OpenFairWind/S3-Outlook-Guardian/hardware/outlook_guardian/fab/outlook_guardian-bottom.png

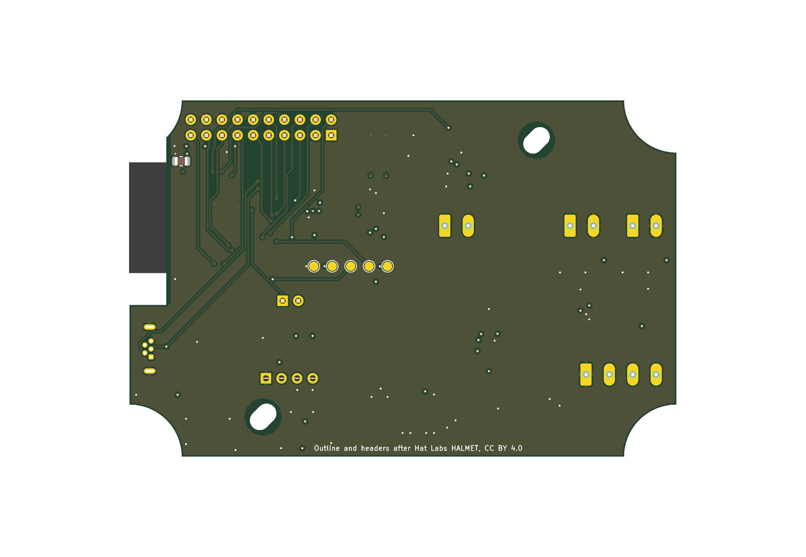
hardware/outlook_guardian/fab/outlook_guardian-bottom.png
