OpenFairWind/S3-Outlook-Guardian/hardware/outlook_guardian/fab/outlook_guardian-top.png

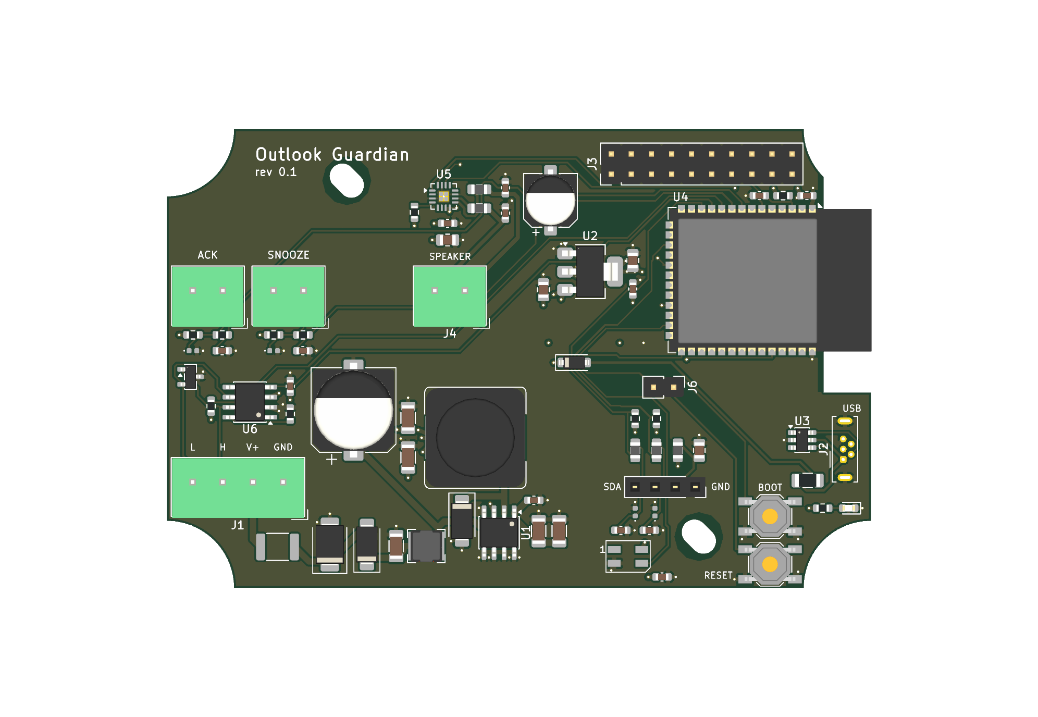
hardware/outlook_guardian/fab/outlook_guardian-top.png
