OpenFairWind/S3-Outlook-Guardian/hardware/outlook_guardian/fab/outlook_guardian-bom.csv

Reference | Value | Footprint | MPN | Qty
C1,C2,C3 | 10uF/50V | Capacitor_SMD:C_1206_3216Metric |  | 3
C4 | 100nF/50V | Capacitor_SMD:C_0603_1608Metric |  | 1
C5 | 220uF/50V | Capacitor_SMD:CP_Elec_10x10.5 |  | 1
C6,C7 | 47uF/10V | Capacitor_SMD:C_1206_3216Metric |  | 2
C8 | 220uF/10V | Capacitor_SMD:CP_Elec_6.3x7.7 |  | 1
C9,C16,C21 | 10uF/16V | Capacitor_SMD:C_0805_2012Metric |  | 3
C10,C12 | 22uF/10V | Capacitor_SMD:C_0805_2012Metric |  | 2
C11,C13,C15,C17,C20,C24,C25 | 100nF | Capacitor_SMD:C_0603_1608Metric |  | 7
C14 | 1uF | Capacitor_SMD:C_0603_1608Metric |  | 1
C18,C19 | 220pF | Capacitor_SMD:C_0603_1608Metric |  | 2
C22,C23 | 33pF | Capacitor_SMD:C_0603_1608Metric |  | 2
D1 | SMBJ33CA | Diode_SMD:D_SMB | SMBJ33CA | 1
D2,D3 | SS34 | Diode_SMD:D_SMA | SS34 | 2
D4 | B5819W | Diode_SMD:D_SOD-123 | B5819W | 1
D5 | SM24CANB | Package_TO_SOT_SMD:SOT-23 | SM24CANB-02HTG | 1
D6 | SK6812MINI | LED_SMD:LED_SK6812MINI_PLCC4_3.5x3.5mm_P1.75mm | SK6812MINI | 1
D7 | Green | LED_SMD:LED_0603_1608Metric |  | 1
D8,D9,D10,D11 | ESD5451N | Diode_SMD:D_0402_1005Metric | ESD5451N | 4
F1 | 1.1A/33V PTC | Fuse:Fuse_1812_4532Metric | 1812L110/33MR | 1
F2 | 1A/6V PTC | Fuse:Fuse_1206_3216Metric | BSMD1206-100-6V | 1
FB1,FB2 | 220R/2A | Inductor_SMD:L_0805_2012Metric | BLM21PG221SN1D | 2
FB3 | 600R | Inductor_SMD:L_0805_2012Metric | GZ2012D601TF | 1
FB4,FB5 | 100R | Inductor_SMD:L_0805_2012Metric | GZ2012D101TF | 2
J1 | NMEA 2000 / power | Connector_Phoenix_MC:PhoenixContact_MCV_1,5_4-G-3.81_1x04_P3.81mm_Vertical | Phoenix MCV 1,5/4-G-3,81 | 1
J2 | USB Micro-B | Connector_USB:USB_Micro-B_Wuerth_614105150721_Vertical | Wuerth 614105150721 | 1
J3 | GPIO | Connector_PinHeader_2.54mm:PinHeader_2x10_P2.54mm_Vertical |  | 1
J4 | Speaker | Connector_Phoenix_MC:PhoenixContact_MCV_1,5_2-G-3.81_1x02_P3.81mm_Vertical | Phoenix MCV 1,5/2-G-3,81 | 1
J5 | Display | Connector_PinSocket_2.54mm:PinSocket_1x04_P2.54mm_Vertical |  | 1
J6 | EN / IO0 | Connector_PinHeader_2.54mm:PinHeader_1x02_P2.54mm_Vertical |  | 1
J7 | Acknowledge | Connector_Phoenix_MC:PhoenixContact_MCV_1,5_2-G-3.81_1x02_P3.81mm_Vertical | Phoenix MCV 1,5/2-G-3,81 | 1
J8 | Snooze | Connector_Phoenix_MC:PhoenixContact_MCV_1,5_2-G-3.81_1x02_P3.81mm_Vertical | Phoenix MCV 1,5/2-G-3,81 | 1
L1 | 10uH/1.5A | Inductor_SMD:L_Bourns-SRN4018 | SRN4018-100M | 1
L2 | 47uH/3A | Inductor_SMD:L_Bourns_SRR1260 | SRR1260-470M | 1
R1 | 2k | Resistor_SMD:R_0603_1608Metric |  | 1
R2,R4,R5,R8,R10 | 10k | Resistor_SMD:R_0603_1608Metric |  | 5
R3 | 1M | Resistor_SMD:R_0603_1608Metric |  | 1
R6,R7 | 4.7k | Resistor_SMD:R_0603_1608Metric |  | 2
R9,R11 | 1k | Resistor_SMD:R_0603_1608Metric |  | 2
SW1 | BOOT | Button_Switch_SMD:SW_SPST_TL3342 | TL3342F160QG | 1
SW2 | RESET | Button_Switch_SMD:SW_SPST_TL3342 | TL3342F160QG | 1
U1 | XL1509-5.0E1 | Package_SO:SOIC-8_3.9x4.9mm_P1.27mm | XL1509-5.0E1 | 1
U2 | AZ1117C-3.3 | Package_TO_SOT_SMD:SOT-223-3_TabPin2 | AZ1117CH-3.3TRG1 | 1
U3 | USBLC6-2SC6 | Package_TO_SOT_SMD:SOT-23-6 | USBLC6-2SC6 | 1
U4 | ESP32-S3-WROOM-1-N16R8 | OutlookGuardian:ESP32-S3-WROOM-1_EdgeAntenna | ESP32-S3-WROOM-1-N16R8 | 1
U5 | MAX98357AETE+T | Package_DFN_QFN:TQFN-16-1EP_3x3mm_P0.5mm_EP1.23x1.23mm | MAX98357AETE+T | 1
U6 | SN65HVD230DR | Package_SO:SOIC-8_3.9x4.9mm_P1.27mm | SN65HVD230DR | 1
