OpenFairWind/S3-Outlook-Guardian/hardware/outlook_guardian/fab/outlook_guardian-schematic.pdf

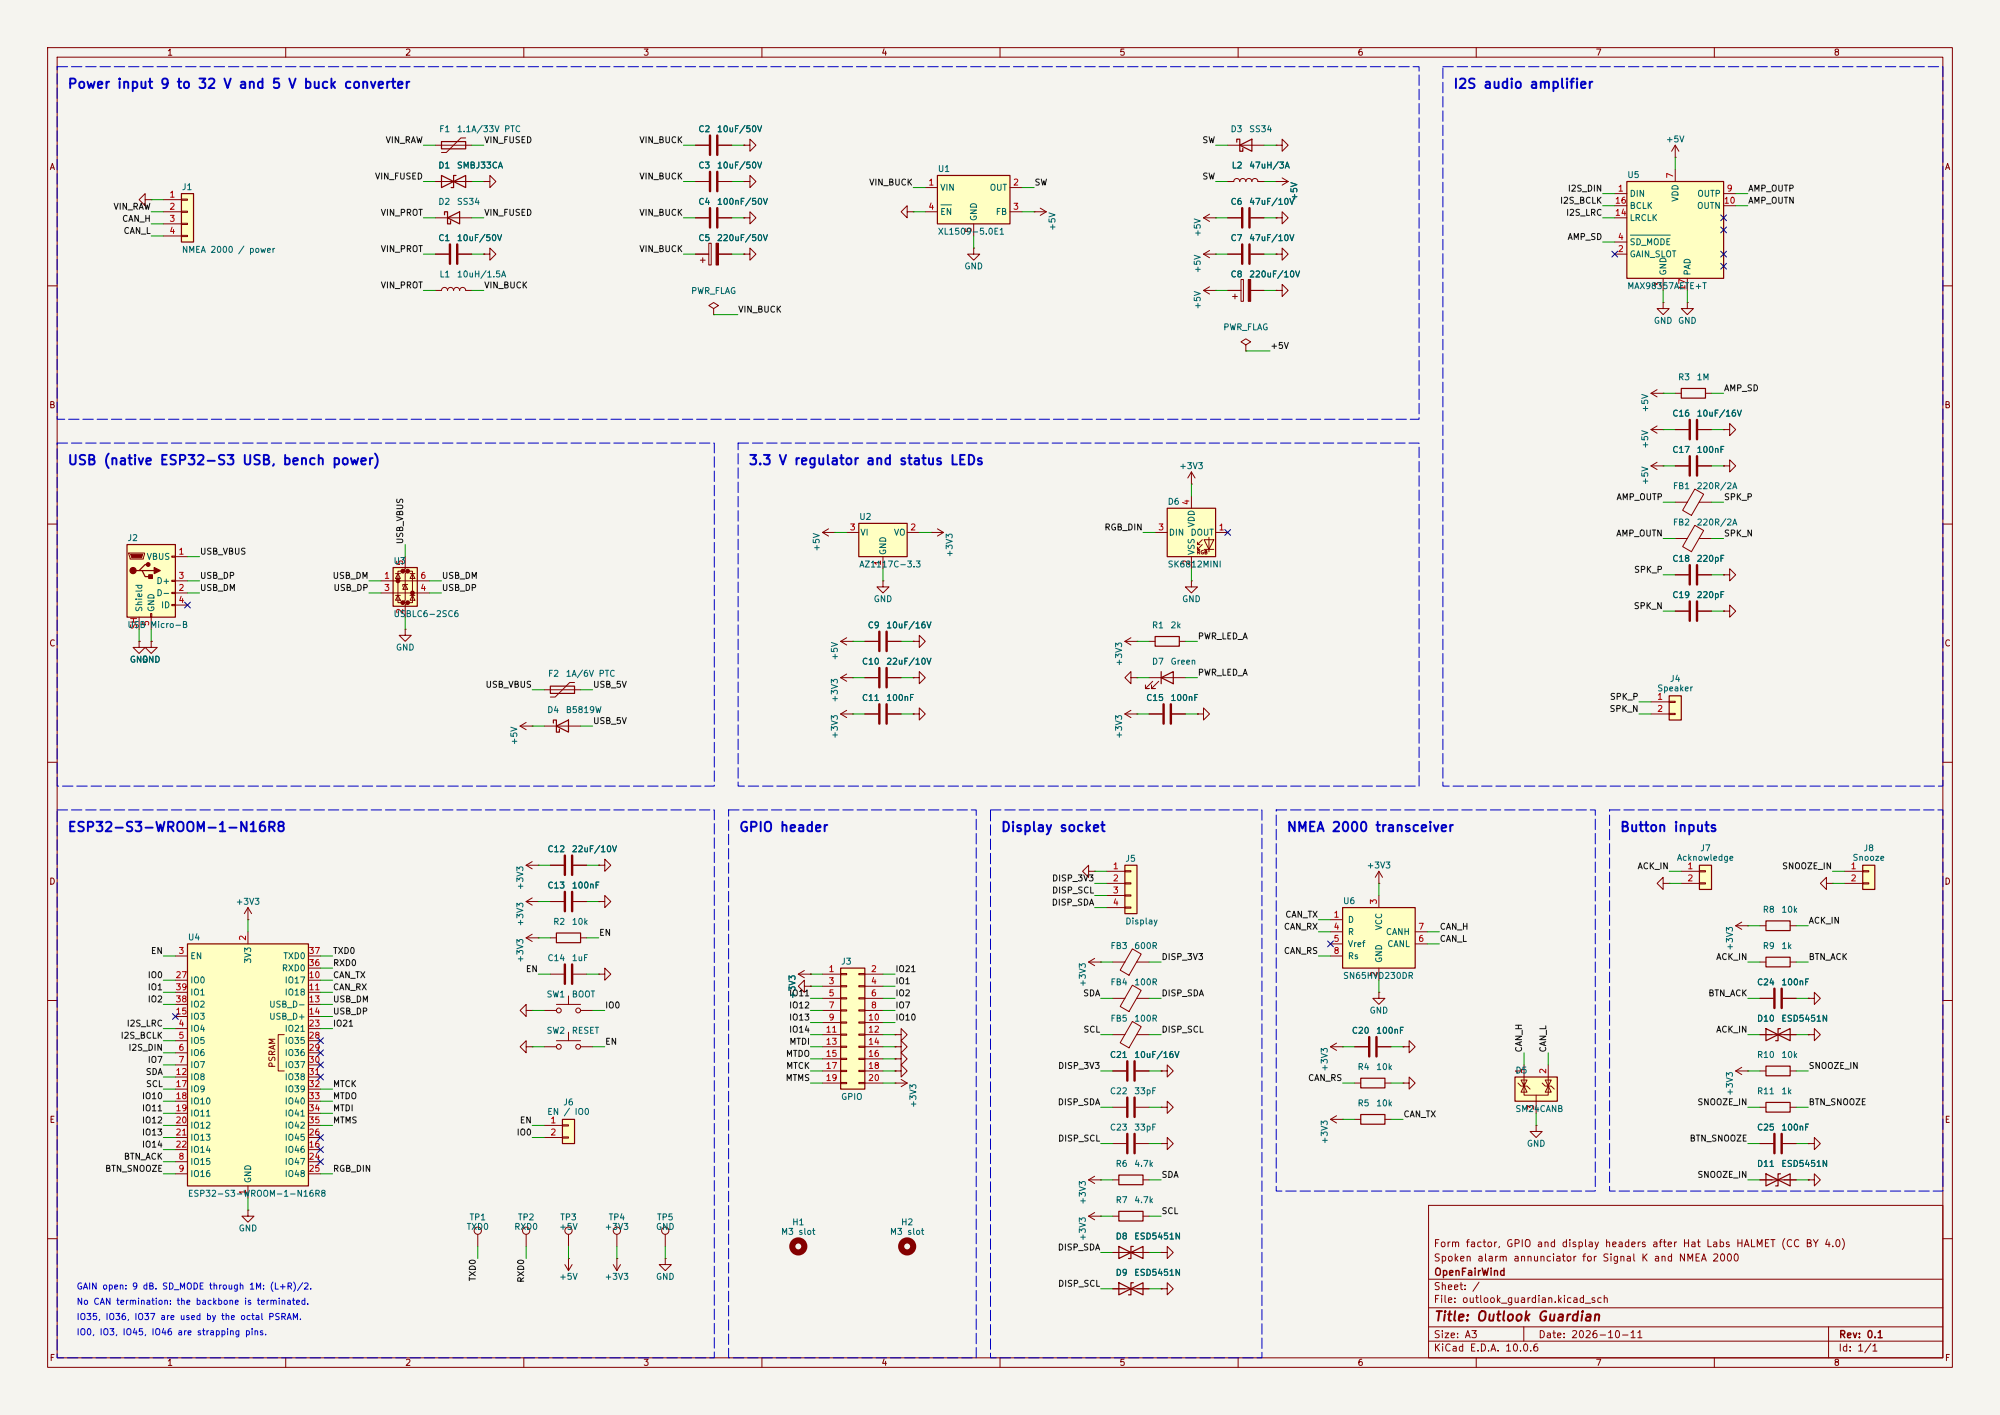
[picture p4: page 1]

Power input 9 to 32 V and 5 V buck converter

No CAN termination: the backbone is terminated. ESP32-S3-WROOM-1-N16R8

Spoken alarm annunciator for Signal K and NMEA 2000
OpenFairWind
Sheet: /
File: outlook_guardian.kicad_sch
Title: Outlook Guardian

IO35, IO36, IO37 are used by the octal PSRAM. GAIN open: 9 dB. SD_MODE through 1M: (L+R)/2.

Size: A3 | Rev: 0.1 | F Date: 2026-10-11
KiCad E.D.A. 10.0.6 | Id: 1/1
