OpenFairWind/S3-Outlook-Guardian/hardware/outlook_guardian/fab/outlook_guardian-assembly.pdf

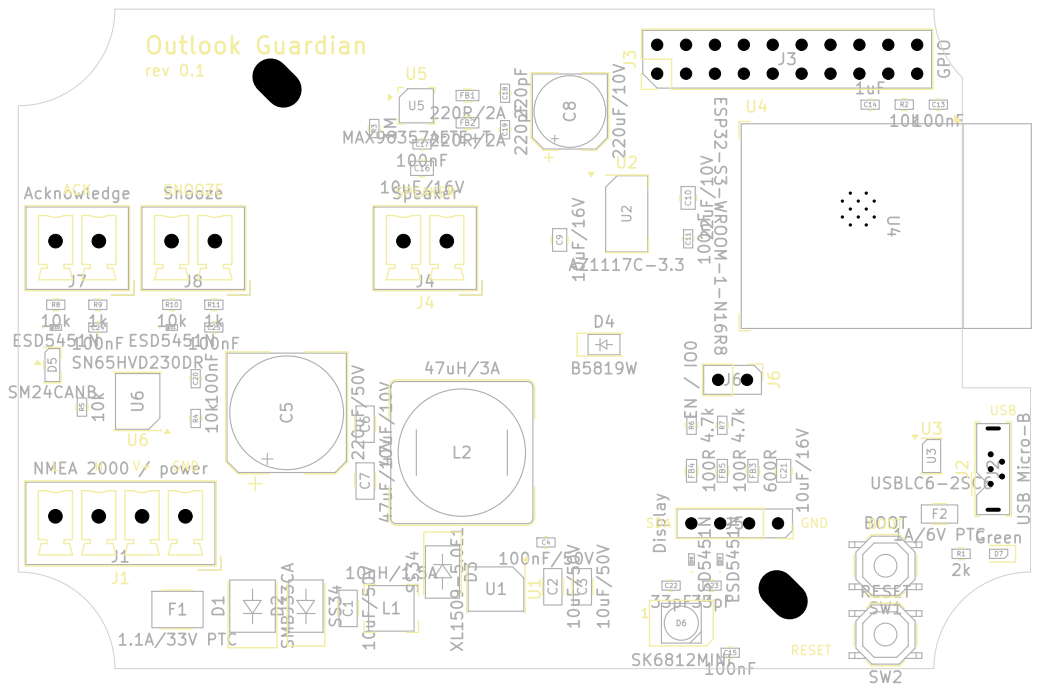
[picture p5: page 1]
