OpenFairWind/S3-Outlook-Guardian/hardware/outlook_guardian/outlook_guardian.kicad_pcb

## KiCad design hardware/outlook_guardian/outlook_guardian.kicad_pcb (2026-10-11)

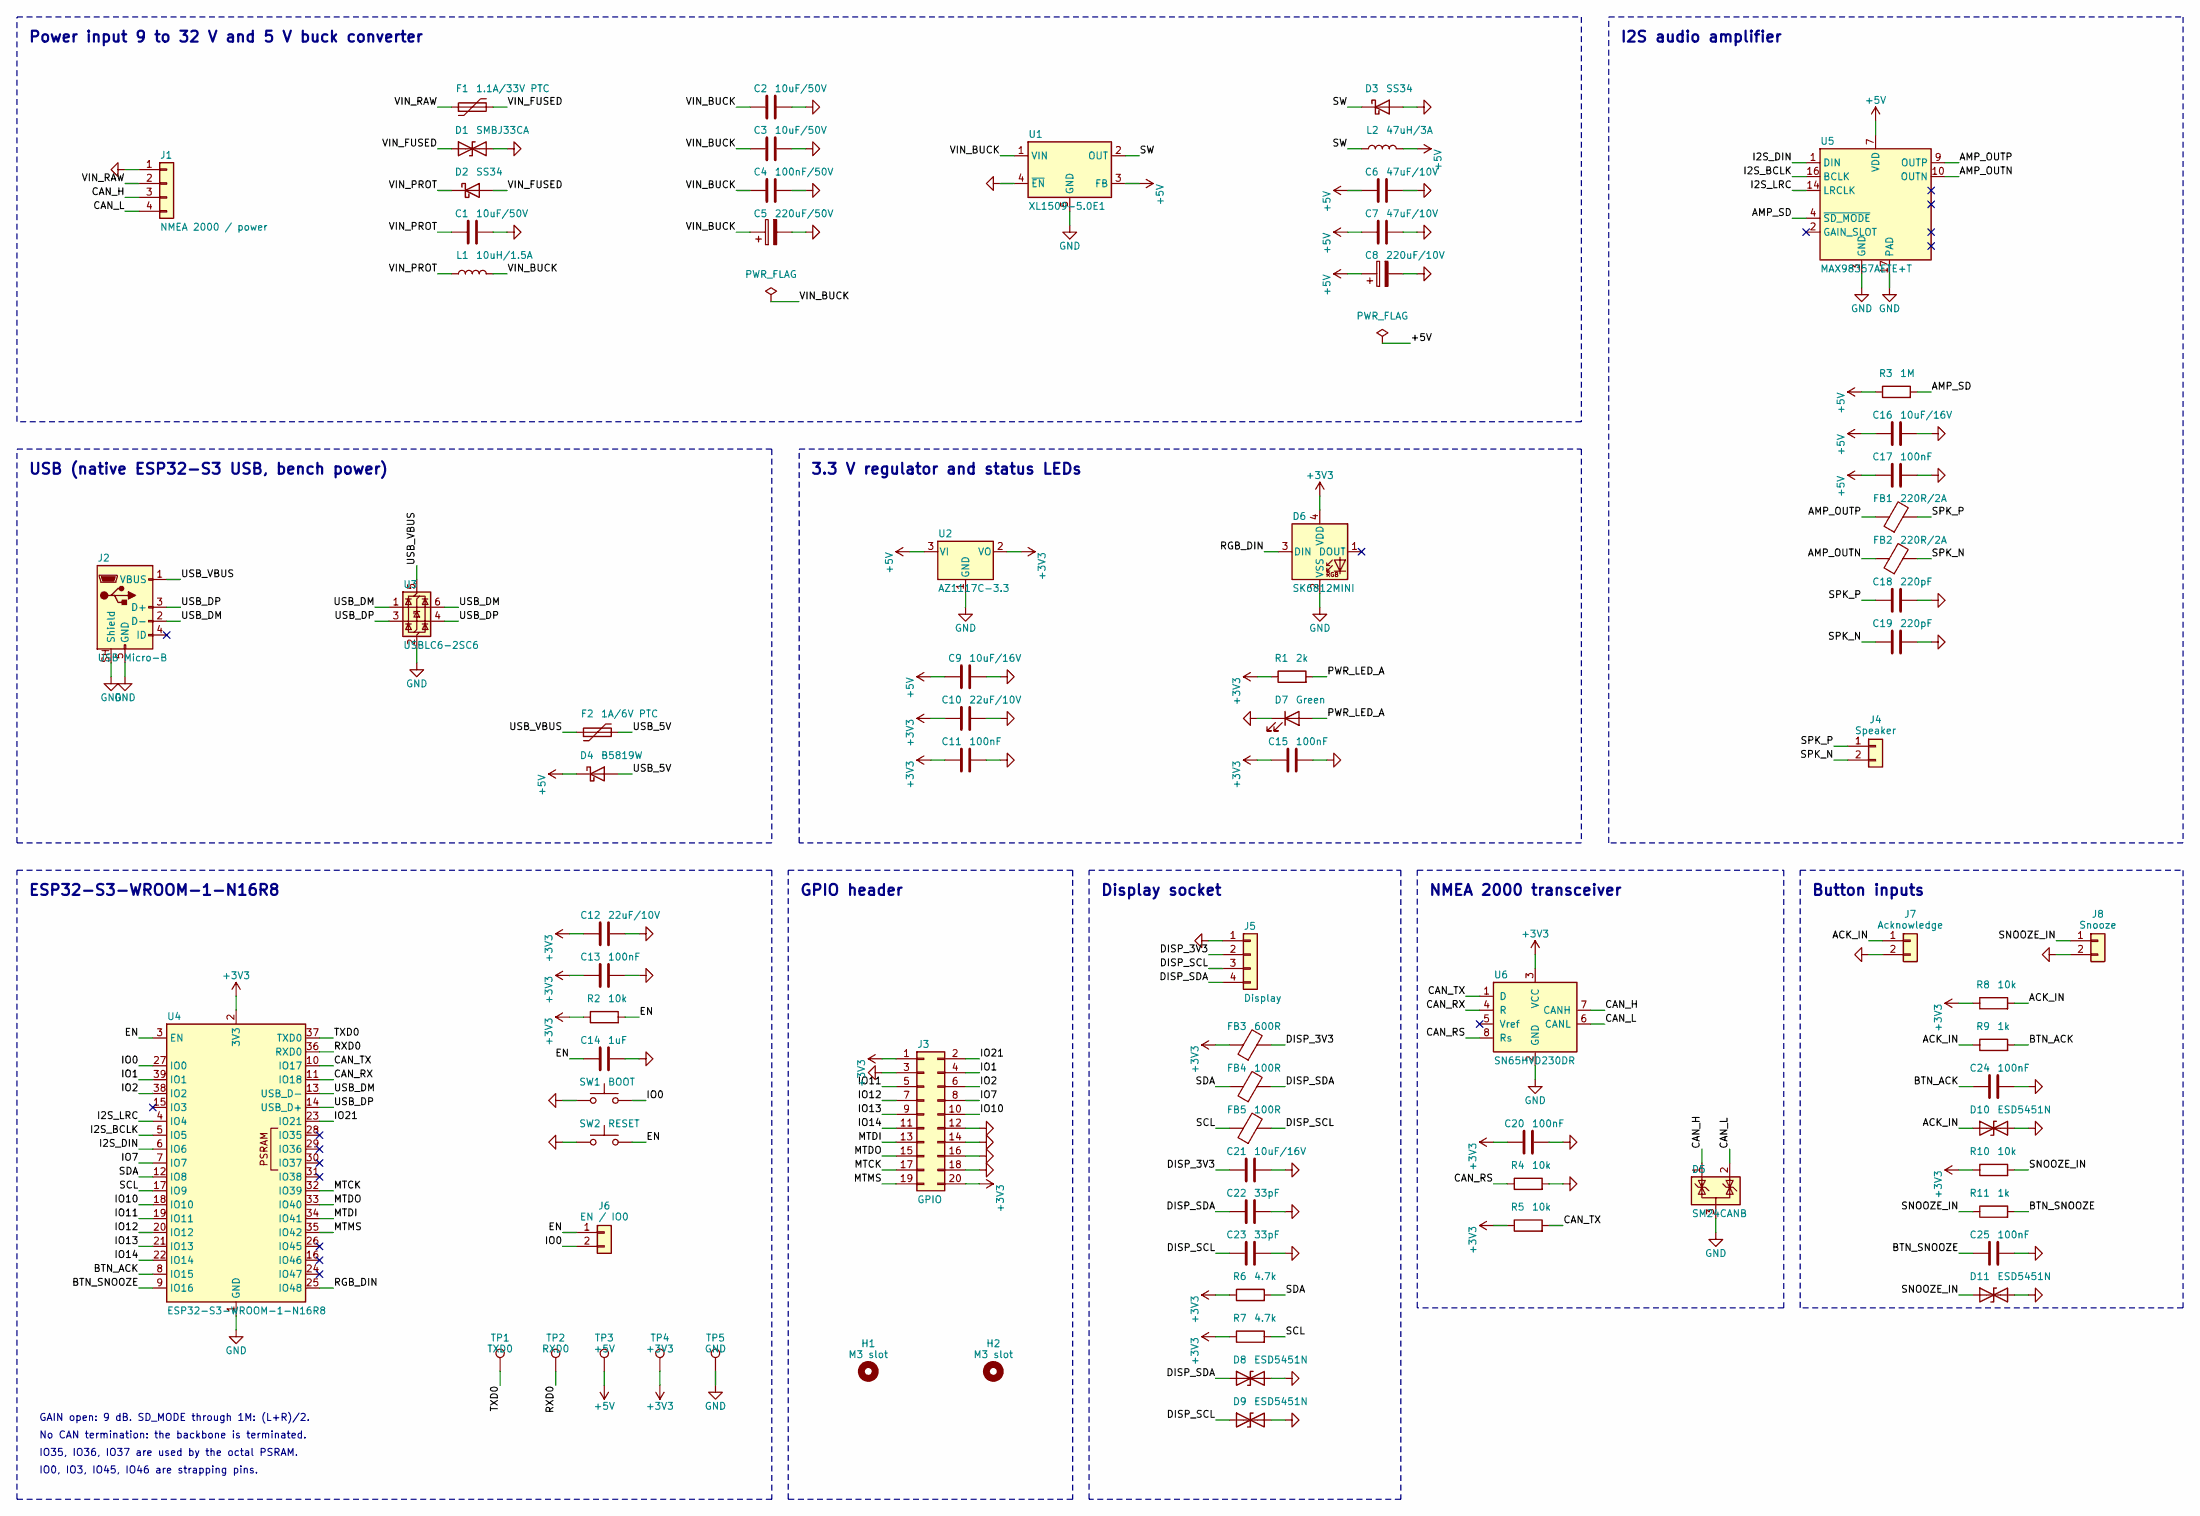
[picture p6: schematic outlook_guardian.kicad_sch, Outlook Guardian]

Parts:
C1, C2, C3: 10uF/50V; C_1206_3216Metric
C4: 100nF/50V; C_0603_1608Metric
C5: 220uF/50V; CP_Elec_10x10.5
C6, C7: 47uF/10V; C_1206_3216Metric
C8: 220uF/10V; CP_Elec_6.3x7.7
C9, C16, C21: 10uF/16V; C_0805_2012Metric
C10, C12: 22uF/10V; C_0805_2012Metric
C11, C13, C15, C17, C20, C24, C25: 100nF; C_0603_1608Metric
C14: 1uF; C_0603_1608Metric
C18, C19: 220pF; C_0603_1608Metric
C22, C23: 33pF; C_0603_1608Metric
D1: SMBJ33CA; D_SMB; MPN SMBJ33CA
D2, D3: SS34; D_SMA; MPN SS34
D4: B5819W; D_SOD-123; MPN B5819W
D5: SM24CANB; SOT-23; MPN SM24CANB-02HTG
D6: SK6812MINI; LED_SK6812MINI_PLCC4_3.5x3.5mm_P1.75mm; MPN SK6812MINI
D7: Green; LED_0603_1608Metric
D8, D9, D10, D11: ESD5451N; D_0402_1005Metric; MPN ESD5451N
F1: 1.1A/33V PTC; Fuse_1812_4532Metric; MPN 1812L110/33MR
F2: 1A/6V PTC; Fuse_1206_3216Metric; MPN BSMD1206-100-6V
FB1, FB2: 220R/2A; L_0805_2012Metric; MPN BLM21PG221SN1D
FB3: 600R; L_0805_2012Metric; MPN GZ2012D601TF
FB4, FB5: 100R; L_0805_2012Metric; MPN GZ2012D101TF
H1, H2: M3 slot; MountingSlot_3.2mm_M3_Unplated
J1: NMEA 2000 / power; PhoenixContact_MCV_1,5_4-G-3.81_1x04_P3.81mm_Vertical; MPN Phoenix MCV 1,5/4-G-3,81
J2: USB Micro-B; USB_Micro-B_Wuerth_614105150721_Vertical; MPN Wuerth 614105150721
J3: GPIO; PinHeader_2x10_P2.54mm_Vertical
J4: Speaker; PhoenixContact_MCV_1,5_2-G-3.81_1x02_P3.81mm_Vertical; MPN Phoenix MCV 1,5/2-G-3,81
J5: Display; PinSocket_1x04_P2.54mm_Vertical
J6: EN / IO0; PinHeader_1x02_P2.54mm_Vertical
J7: Acknowledge; PhoenixContact_MCV_1,5_2-G-3.81_1x02_P3.81mm_Vertical; MPN Phoenix MCV 1,5/2-G-3,81
J8: Snooze; PhoenixContact_MCV_1,5_2-G-3.81_1x02_P3.81mm_Vertical; MPN Phoenix MCV 1,5/2-G-3,81
L1: 10uH/1.5A; L_Bourns-SRN4018; MPN SRN4018-100M
L2: 47uH/3A; L_Bourns_SRR1260; MPN SRR1260-470M
R1: 2k; R_0603_1608Metric
R2, R4, R5, R8, R10: 10k; R_0603_1608Metric
R3: 1M; R_0603_1608Metric
R6, R7: 4.7k; R_0603_1608Metric
R9, R11: 1k; R_0603_1608Metric
SW1: BOOT; SW_SPST_TL3342; MPN TL3342F160QG
SW2: RESET; SW_SPST_TL3342; MPN TL3342F160QG
TP1: TXD0; TestPoint_Pad_D1.5mm
TP2: RXD0; TestPoint_Pad_D1.5mm
TP3: +5V; TestPoint_Pad_D1.5mm
TP4: +3V3; TestPoint_Pad_D1.5mm
TP5: GND; TestPoint_Pad_D1.5mm
U1: XL1509-5.0E1; SOIC-8_3.9x4.9mm_P1.27mm; MPN XL1509-5.0E1
U2: AZ1117C-3.3; SOT-223-3_TabPin2; MPN AZ1117CH-3.3TRG1
U3: USBLC6-2SC6; SOT-23-6; MPN USBLC6-2SC6
U4: ESP32-S3-WROOM-1-N16R8; ESP32-S3-WROOM-1_EdgeAntenna; MPN ESP32-S3-WROOM-1-N16R8
U5: MAX98357AETE+T; TQFN-16-1EP_3x3mm_P0.5mm_EP1.23x1.23mm; MPN MAX98357AETE+T
U6: SN65HVD230DR; SOIC-8_3.9x4.9mm_P1.27mm; MPN SN65HVD230DR

Connections:
+3V3: C10.1, C11.1, C12.1, C13.1, C15.1, C20.1, D6.4 (VDD), FB3.1, J3.1, J3.20, R1.1, R2.1, R5.1, R6.1, R7.1, R8.1, R10.1, TP4.1, U2.2 (VO), U4.2 (3V3), U6.3 (VCC)
+5V: C6.1, C7.1, C8.1, C9.1, C16.1, C17.1, D4.1 (K), L2.2, R3.1, TP3.1, U1.3 (FB), U2.3 (VI), U5.7 (VDD), U5.8 (VDD)
/ACK_IN: D10.1 (A1), J7.1, R8.2, R9.1
/AMP_OUTN: FB2.1, U5.10 (OUTN)
/AMP_OUTP: FB1.1, U5.9 (OUTP)
/AMP_SD: R3.2, U5.4 (~SD_MODE)
/BTN_ACK: C24.1, R9.2, U4.8 (IO15)
/BTN_SNOOZE: C25.1, R11.2, U4.9 (IO16)
/CAN_H: D5.1 (K), J1.3, U6.7 (CANH)
/CAN_L: D5.2 (K), J1.4, U6.6 (CANL)
/CAN_RS: R4.1, U6.8 (Rs)
/CAN_RX: U4.11 (IO18), U6.4 (R)
/CAN_TX: R5.2, U4.10 (IO17), U6.1 (D)
/DISP_3V3: C21.1, FB3.2, J5.2
/DISP_SCL: C23.1, D9.1 (A1), FB5.2, J5.3
/DISP_SDA: C22.1, D8.1 (A1), FB4.2, J5.4
/EN: C14.1, J6.1, R2.2, SW2.2, U4.3 (EN)
/I2S_BCLK: U4.5 (IO5), U5.16 (BCLK)
/I2S_DIN: U4.6 (IO6), U5.1 (DIN)
/I2S_LRC: U4.4 (IO4), U5.14 (LRCLK)
/IO0: J6.2, SW1.2, U4.27 (IO0)
/IO1: J3.4, U4.39 (IO1)
/IO2: J3.6, U4.38 (IO2)
/IO7: J3.8, U4.7 (IO7)
/IO10: J3.10, U4.18 (IO10)
/IO11: J3.5, U4.19 (IO11)
/IO12: J3.7, U4.20 (IO12)
/IO13: J3.9, U4.21 (IO13)
/IO14: J3.11, U4.22 (IO14)
/IO21: J3.2, U4.23 (IO21)
/MTCK: J3.17, U4.32 (IO39)
/MTDI: J3.13, U4.34 (IO41)
/MTDO: J3.15, U4.33 (IO40)
/MTMS: J3.19, U4.35 (IO42)
/PWR_LED_A: D7.2 (A), R1.2
/RGB_DIN: D6.3 (DIN), U4.25 (IO48)
/RXD0: TP2.1, U4.36 (RXD0)
/SCL: FB5.1, R7.2, U4.17 (IO9)
/SDA: FB4.1, R6.2, U4.12 (IO8)
/SNOOZE_IN: D11.1 (A1), J8.1, R10.2, R11.1
/SPK_N: C19.1, FB2.2, J4.2
/SPK_P: C18.1, FB1.2, J4.1
/SW: D3.1 (K), L2.1, U1.2 (OUT)
/TXD0: TP1.1, U4.37 (TXD0)
/USB_5V: D4.2 (A), F2.2
/USB_DM: J2.2 (D-), U3.1 (I/O1), U3.6 (I/O1), U4.13 (USB_D-)
/USB_DP: J2.3 (D+), U3.3 (I/O2), U3.4 (I/O2), U4.14 (USB_D+)
/USB_VBUS: F2.1, J2.1 (VBUS), U3.5 (VBUS)
/VIN_BUCK: C2.1, C3.1, C4.1, C5.1, L1.2, U1.1 (VIN)
/VIN_FUSED: D1.1 (A1), D2.2 (A), F1.2
/VIN_PROT: C1.1, D2.1 (K), L1.1
/VIN_RAW: F1.1, J1.2
GND: C1.2, C2.2, C3.2, C4.2, C5.2, C6.2, C7.2, C8.2, C9.2, C10.2, C11.2, C12.2, C13.2, C14.2, C15.2, C16.2, C17.2, C18.2, C19.2, C20.2, C21.2, C22.2, C23.2, C24.2, C25.2, D1.2 (A2), D3.2 (A), D5.3 (A), D6.2 (VSS), D7.1 (K), D8.2 (A2), D9.2 (A2), D10.2 (A2), D11.2 (A2), J1.1, J2.5 (GND), J2.SH (Shield), J3.3, J3.12, J3.14, J3.16, J3.18, J5.1, J7.2, J8.2, R4.2, SW1.1, SW2.1, TP5.1, U1.4 (~EN), U1.5 (GND), U1.6 (GND), U1.7 (GND), U1.8 (GND), U2.1 (GND), U3.2 (GND), U4.1 (GND), U4.40 (GND), U4.41 (GND), U5.3 (GND), U5.11 (GND), U5.15 (GND), U5.17 (PAD), U6.2 (GND)

Notes on the sheet:
IO0, IO3, IO45, IO46 are strapping pins.
ESP32-S3-WROOM-1-N16R8
3.3 V regulator and status LEDs
I2S audio amplifier
NMEA 2000 transceiver
USB (native ESP32-S3 USB, bench power)
Power input 9 to 32 V and 5 V buck converter
GPIO header
No CAN termination: the backbone is terminated.
GAIN open: 9 dB. SD_MODE through 1M: (L+R)/2.
Display socket
IO35, IO36, IO37 are used by the octal PSRAM.
Button inputs

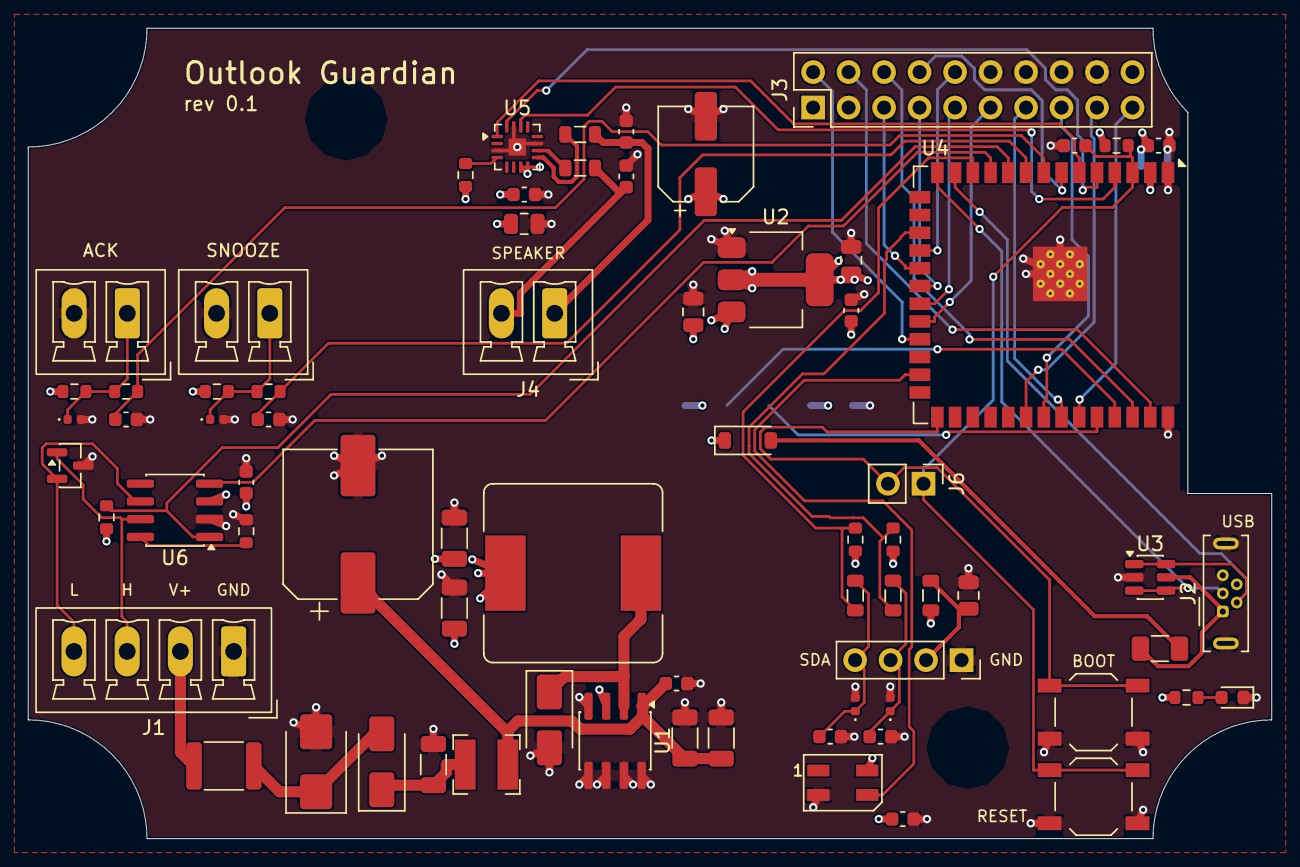
[picture p7: board outlook_guardian.kicad_pcb from above]

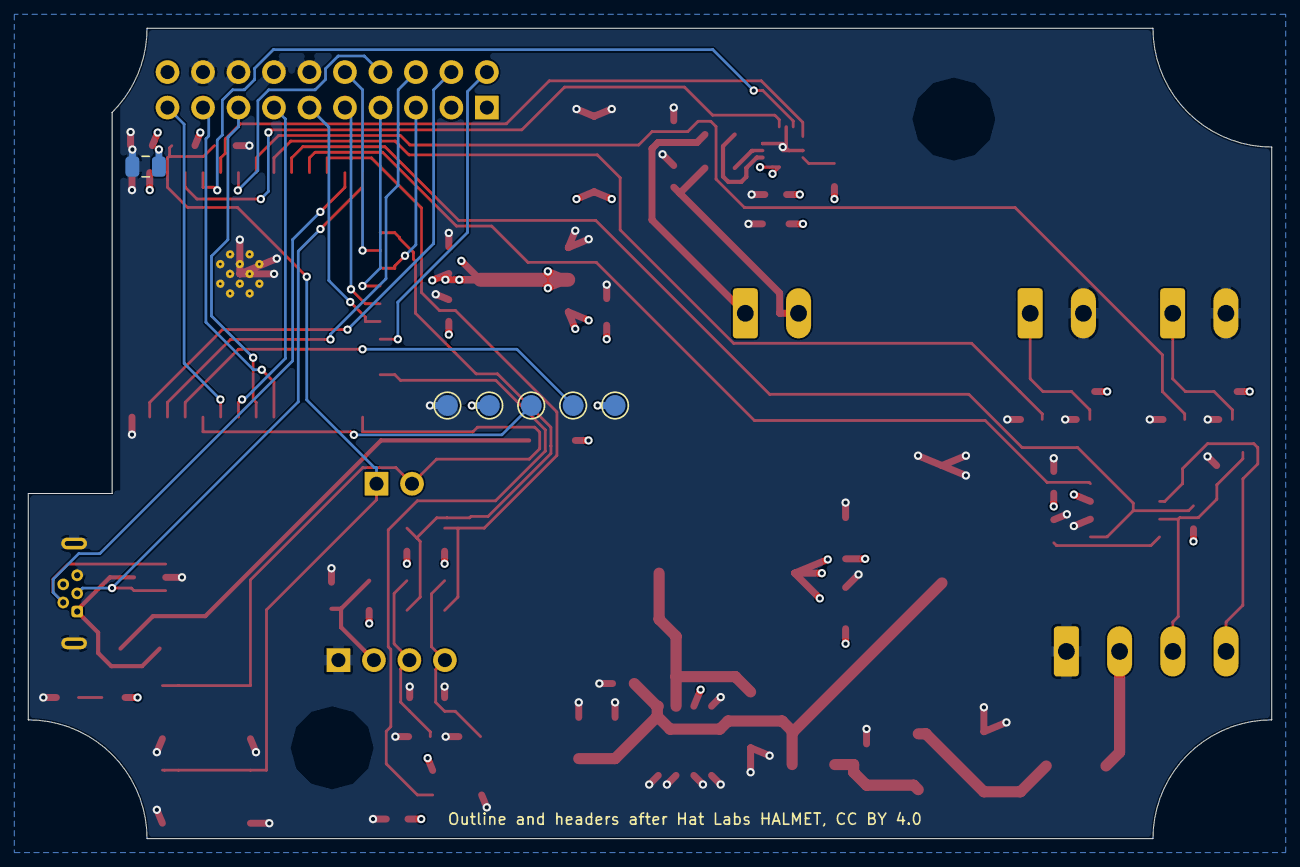
[picture p8: board outlook_guardian.kicad_pcb from below]

Board: 4 copper layers, 89.0 x 58.0 mm, 79 parts (6 on the bottom side), 53 nets.
