OpenFairWind/S3-Outlook-Guardian/hardware/outlook_guardian/tools/placement.py

"""Footprint positions on the board: ref -> (x mm, y mm, rotation deg[, "B" for the back]).

Coordinates are those of the HALMET board file, so the parts marked HALMET sit
exactly where HALMET has them.
"""

PLACE = {
    # --- fixed by the HALMET form factor ---------------------------------
    "U4": (165.318, 76.08, -90),      # module, antenna overhanging the edge (HALMET)
    "J3": (145.175, 62.675, 90),      # GPIO header (HALMET J201)
    "J5": (155.8, 102.225, -90),      # display socket (HALMET J702)
    "J6": (153.075, 89.6, -90),       # EN / IO0 header (HALMET J302)
    "J1": (103.6975, 101.6, 180),     # NMEA 2000 / power terminal block (HALMET J802)
    "J2": (174.5, 98.75, 90),         # USB socket (HALMET J401)
    "SW1": (165.25, 105.95, 180),     # BOOT (HALMET SW501)
    "SW2": (165.25, 112.0, 180),      # RESET (HALMET SW502)
    "H1": (111.75, 63.5, 135),        # mounting slots (HALMET H1001, H1002)
    "H2": (156.25, 108.5, 135),
    # --- terminal blocks on HALMET's upper connector row ------------------
    "J7": (96.0875, 77.4, 180),       # Acknowledge button
    "J8": (106.2875, 77.4, 180),      # Snooze button
    "J4": (126.6775, 77.4, 180),      # Speaker
    # --- power input and 5 V buck ----------------------------------------
    "F1": (103.0, 109.8, 0),
    "D1": (109.6, 109.5, 90),
    "D2": (114.3, 109.5, 90),
    "C1": (118.0, 109.7, 90),
    "L1": (121.8, 109.7, 0),
    "C2": (136.0, 107.8, 90),
    "C3": (138.6, 107.8, 90),
    "C4": (135.4, 103.9, 0),
    "U1": (131.0, 108.0, -90),
    "D3": (126.3, 106.5, -90),
    "C5": (112.6, 92.5, 90),
    "L2": (128.0, 96.0, 180),
    "C6": (119.5, 93.5, 90),
    "C7": (119.5, 98.5, 90),
    "C8": (137.5, 66.0, 90),
    # --- 3.3 V regulator ---------------------------------------------------
    "U2": (142.5, 75.0, 0),
    "C9": (136.6, 77.3, 90),
    "C10": (147.9, 73.6, 90),
    "C11": (147.9, 77.2, 90),
    # --- USB -----------------------------------------------------------------
    "U3": (169.3, 96.3, 0),
    "F2": (170.0, 101.4, 0),
    "D4": (140.5, 86.5, 0),
    # --- LEDs ----------------------------------------------------------------
    "D7": (175.2, 104.9, 180),
    "R1": (171.9, 104.9, 0),
    "D6": (147.3, 111.0, 0),
    "C15": (151.6, 113.6, 0),
    # --- module support -----------------------------------------------------
    "C12": (169.6, 66.9, 180, "B"),
    "C13": (169.9, 65.4, 0),
    "R2": (166.9, 65.4, 0),
    "C14": (163.9, 65.4, 180),
    "TP1": (139.0, 84.0, 0, "B"),
    "TP2": (142.0, 84.0, 0, "B"),
    "TP3": (136.0, 84.0, 0, "B"),
    "TP4": (145.0, 84.0, 0, "B"),
    "TP5": (148.0, 84.0, 0, "B"),
    # --- audio amplifier ----------------------------------------------------
    "U5": (124.0, 65.5, 0),
    "R3": (120.3, 67.5, 90),
    "C16": (124.5, 71.0, 0),
    "C17": (124.5, 68.9, 0),
    "FB1": (128.5, 64.6, 0),
    "FB2": (128.5, 67.0, 0),
    "C18": (131.8, 64.4, 90),
    "C19": (131.8, 67.6, 90),
    # --- NMEA 2000 transceiver --------------------------------------------
    "U6": (99.5, 91.5, 180),
    "C20": (104.6, 89.5, 90),
    "R4": (104.6, 93.0, 90),
    "R5": (94.6, 92.0, 90),
    "D5": (92.0, 88.3, 0),
    # --- display socket filter --------------------------------------------
    "FB3": (153.6, 97.6, 90),
    "FB4": (148.2, 97.6, 90),
    "FB5": (150.9, 97.6, 90),
    "C21": (156.3, 97.6, 90),
    "C22": (146.4, 107.7, 0),
    "C23": (150.0, 107.7, 0),
    "R6": (148.2, 93.6, 90),
    "R7": (150.9, 93.6, 90),
    "D8": (148.2, 105.4, 90),
    "D9": (150.7, 105.4, 90),
    # --- button inputs ------------------------------------------------------
    "R8": (92.3, 83.0, 0),
    "R9": (96.0, 83.0, 0),
    "C24": (96.0, 85.0, 0),
    "D10": (92.3, 85.0, 0),
    "R10": (102.5, 83.0, 0),
    "R11": (106.2, 83.0, 0),
    "C25": (106.2, 85.0, 0),
    "D11": (102.5, 85.0, 0),
}
