OpenFairWind/S3-Outlook-Guardian/(commit log)

2026-10-10 docs: make the Outlook Guardian guide step-by-step from a bare board
    Restructure the pages into four numbered steps (hardware, software and
    flashing, WiFi and Signal K, configure and test), add the first-start
    page with the access point password and address, and a test alarm
    walk-through.
2026-10-11 feat: Outlook Guardian display, alarm source settings and audio fault LED
    - Show the network and stream status and the latest notification on an
    optional SSD1306 display. The firmware works the same without it and
    finds a display plugged in later.
    - Open the access point again when the WiFi network cannot be joined.
    - Make the welcome message configurable, or disable it.
    - Choose the Signal K notification paths to subscribe to and the NMEA 2000
    alert types and categories to announce.
    - Flash the RGB LED red when the audio output fails to start, and keep
    handling the alarms without speech.
    - Document the complete hardware setup with a wiring diagram, the power
    supply and a connectio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
    [outlook_guardian.cpp]
2026-10-11 docs: cover a 9 to 32 V boat supply in the Outlook Guardian hardware guide
    Specify a wide-input fixed 5 V converter, add reverse-polarity, surge and
    cranking-dip protection, raise the fuse to 2 A, and note the NMEA 2000
    supply limits and the grounding of non-isolated converters.
2026-10-11 docs: add a photo of the Outlook Guardian prototype to the README
2026-10-11 feat: Outlook Guardian board in the HALMET form factor (KiCad, rev 0.1)
    A four-layer KiCad 10 project that replaces the breadboard build: an
    ESP32-S3-WROOM-1-N16R8, a MAX98357A amplifier, an SN65HVD230 CAN
    transceiver, a 9 to 32 V protected input with a 5 V buck converter, and
    terminal blocks for the speaker and the two buttons.
    The outline, the mounting slots and the positions of the module, the
    GPIO header, the display socket, the NMEA 2000 terminal block, the USB
    socket and the buttons are those of the Hat Labs HALMET (CC BY 4.0).
    The on-board functions use the pins the firmware already defaults to.
    The schematic and the board are generated by the scripts in tools/ and
    autorouted with F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
    [outlook_guardian-B_Cu.gbr, outlook_guardian-B_Mask.gbr, outlook_guardian-B_Paste.gbr, outlook_guardian-B_Silkscreen.gbr, outlook_guardian-Edge_Cuts.gbr, outlook_guardian-F_Cu.gbr, outlook_guardian-F_Mask.gbr, outlook_guardian-F_Paste.gbr]
2026-10-12 fix: keep the Outlook Guardian display visible while dimmed
    Adafruit_SSD1306::dim(true) sets the contrast to 0, which some SSD1306
    panels render as completely dark: the boot banner showed, then the
    status screen vanished as soon as it was dimmed with no alarm raised.
    Dim to a low, non-zero contrast instead (OLED_DIM_CONTRAST, 0x20).
    [outlook_guardian.cpp]
2026-10-12 docs: license the Outlook Guardian board design under CC BY 4.0
    Add the CC BY 4.0 text next to the hardware design and state in both
    READMEs that it covers the board only; the firmware stays under the
    Apache License 2.0.
